dbsb-juntendo/descSPIM/README.md

# descSPIM

**descSPIM : affordable but versatile light-sheet microscopy system for tissue clearing end users**

descSPIM_CAD_for_GitHub_middle

## What is descSPIM?

descSPIM is a lightsheet microscopy system that we designed to meet the unmet needs of researchers who are using tissue clearing techniques. The system offers a low-cost and easy-to-use solution for 3D imaging of cleared tissue samples that requires little expertise and cost. Most optical components are readily available from a single vendor and can be readily assembled using the instructions provided. These minimal optical parts are arranged on a small optical breadboard. In contrast to existing lightsheet systems, descSPIM is intended to be simple to install, build, and operate, even for end users with no prior experience in optics. descSPIM is also highly expandable and can be customized to suit a variety of applications, making it a versatile tool for a wide range of research projects. With descSPIM, researchers can easily achieve practical-quality 3D imaging of cleared specimens in a daily experiments.

descSPIM_cost_vs_expertise_for_GitHub (1)_middle

The main features of descSPIM are:

**✓ Easy-to-build**

**✓ Easy-to-operate (use a cuvette / no oil chamber)**

**✓ Affordable ($20k-50k for descSPIM-basic, depending on the number of lasers)**

**✓ Compact (all parts on a 300 mm x 450 mm breadboard)**

**✓ Versatile (highly expandable and customizable)**

##

## Who is the descSPIM for?

Researchers interested in using **Light-sheet fluorescence microscopy (LSFM)** for cleared tissue imaging

##

## What are ideal imaging applications for a descSPIM?

・Macro- to meso-scale imaging of 3D volumetric samples prepared by tissue clearing techniques with strong efficiency (CUBIC, BABB, DISCO, SHIELDs etc.)

・Visualization of cell populations or anatomical structures (e.g. blood vessels, plaques) with cellular to sub-cellular resolutions

## 

## Guide to install

It is recommended to start learning [Basic of optics](https://github.com/dbsb-juntendo/descSPIM/blob/main/DOCs/Basics%20of%20optics.md) 

and [Cleared sample preparation](https://github.com/dbsb-juntendo/descSPIM/blob/main/DOCs/Cleared%20sample%20preparation.md), 

then to introduce [descSPIM-basic](https://github.com/dbsb-juntendo/descSPIM/blob/main/descSPIM-basic/descSPIM-basic.md). 

Add-on functions are developed to be compatible with the basic system.

Add-ons: (under construction)

Related codes can be found here:  
- For general data processing -> [Data processing](https://github.com/dbsb-juntendo/descSPIM/blob/main/DOCs/Data%20processing.md)  
- For false colored HE (hematoxylin & eosin) 3D converting -> [Fluo-HE](https://github.com/dbsb-juntendo/descSPIM/blob/main/DOCs/Fluo-HE.md)
- For drug distrubution analysis using trastuzumab-DyLightTM 650 -> [DrugDistributionAnalysis](https://github.com/dbsb-juntendo/descSPIM/blob/main/DOCs/DrugDistributionAnalysis.md)

>[!NOTE]
>We only tested the codes python 3.9.16 on Ubuntu 20.04 environment.  
>Registration was performed using ANTs software (v2.4.3.post10-g871cad0).
## 

## FAQ

You can see answers for Frequently Asked Questions [here](https://github.com/dbsb-juntendo/descSPIM/blob/main/DOCs/FAQ.md). 

## 

## Terms and Conditions

<br />This work is licensed under a <a rel="license" href="http://creativecommons.org/licenses/by-nc-sa/4.0/">Creative Commons Attribution-NonCommercial-ShareAlike 4.0 International License</a>.

By using descSPIM, you agree to abide by these terms and conditions:

- This system is only available for academic use. Any use for commercial purposes is strictly prohibited, unless permission is granted by the authors.

- Academic users are allowed to use, apply, and adopt the system in accordance with the CC by 4.0 license policy. This includes modifications, adaptations, and redistribution of the system and its components.

- If any commercial enterprise wants to use, produce, or sell the system, they must contact the authors (suishess-kyu@umin.ac.jp) to request permission.

- All users of the system must acknowledge and refer to the original paper (Otomo et al. bioRxiv 2023) in any publications or presentations resulting from the use of the system.

- The authors are not responsible for any consequences arising from the use of this system as well as related tools, scripts, and software. Users assume all risks and liabilities associated with the use.

- The authors reserve the right to modify or terminate the system and its services at any time, without prior notice.

- Users agree to comply with all applicable laws and regulations regarding the use of the system.

- Any disputes arising from the use of this system shall be resolved through negotiation between the parties. If a resolution cannot be reached, the dispute shall be submitted to binding arbitration in accordance with the laws of Japan.

## 

## References

- [Otomo et al. descSPIM: Affordable and Easy-to-Build Light-Sheet Microscopy for Clearing Technique Users. bioRxiv (2023)](https://www.biorxiv.org/content/10.1101/2023.05.02.539136v2) 

- [Susaki et al. Versatile whole-organ/body staining and imaging based on electrolyte-gel properties of biological tissues. Nat Commun 11, 1982 (2020)](https://doi.org/10.1038/s41467-020-15906-5)

- [Matsumoto et al. Advanced CUBIC tissue clearing for whole-organ cell profiling. Nat Protoc 14, 3506–3537 (2019)](https://doi.org/10.1038/s41596-019-0240-9)

- [CUBIC resource website](http://cubic.riken.jp)
