dbsb-juntendo/descSPIM/Codes and software.md

## Flatfiled correction: ImageJ macro
[Download here](https://github.com/dbsb-juntendo/descSPIM/blob/main/FlatfieldCorrection_IJmacro_ver230406.ijm)

How to use:
1. prepare a reference xy image(1) and a sample xyz stack(2). 

(1) a reference xy image

In order to get the reference image, hogehoge... acquired using dye-solving solution (e.g., CUBIC-R + FITC reagent)...

(2) a sample xyz image stack to be corrected

2. run macro with ImageJ/Fiji
