dbsb-juntendo/descSPIM/descSPIM-basic/descSPIM_3Dimaging_ver230520.pdf

# 3D imaging procedures of descSPIM

# (ver. 230520)

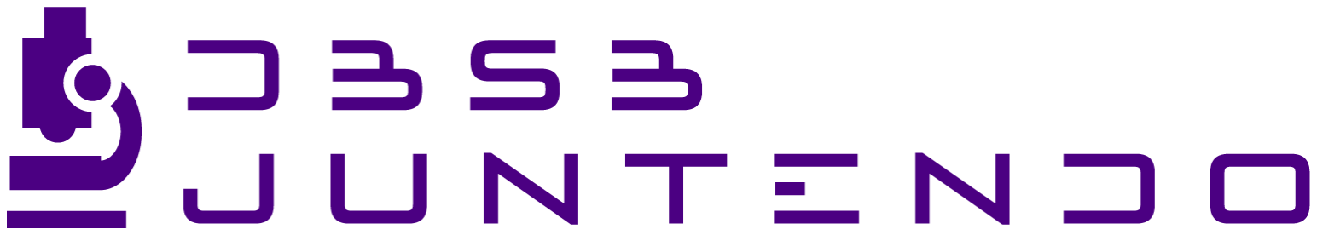
[picture p1: figure]

Provided by Department of Biochemistry and Systems Biomedicine, Graduate School of Medicine, Juntendo University. All Rights Reserved.

## 3D imaging (bioRxiv 2023; Supplementary Fig. 4)

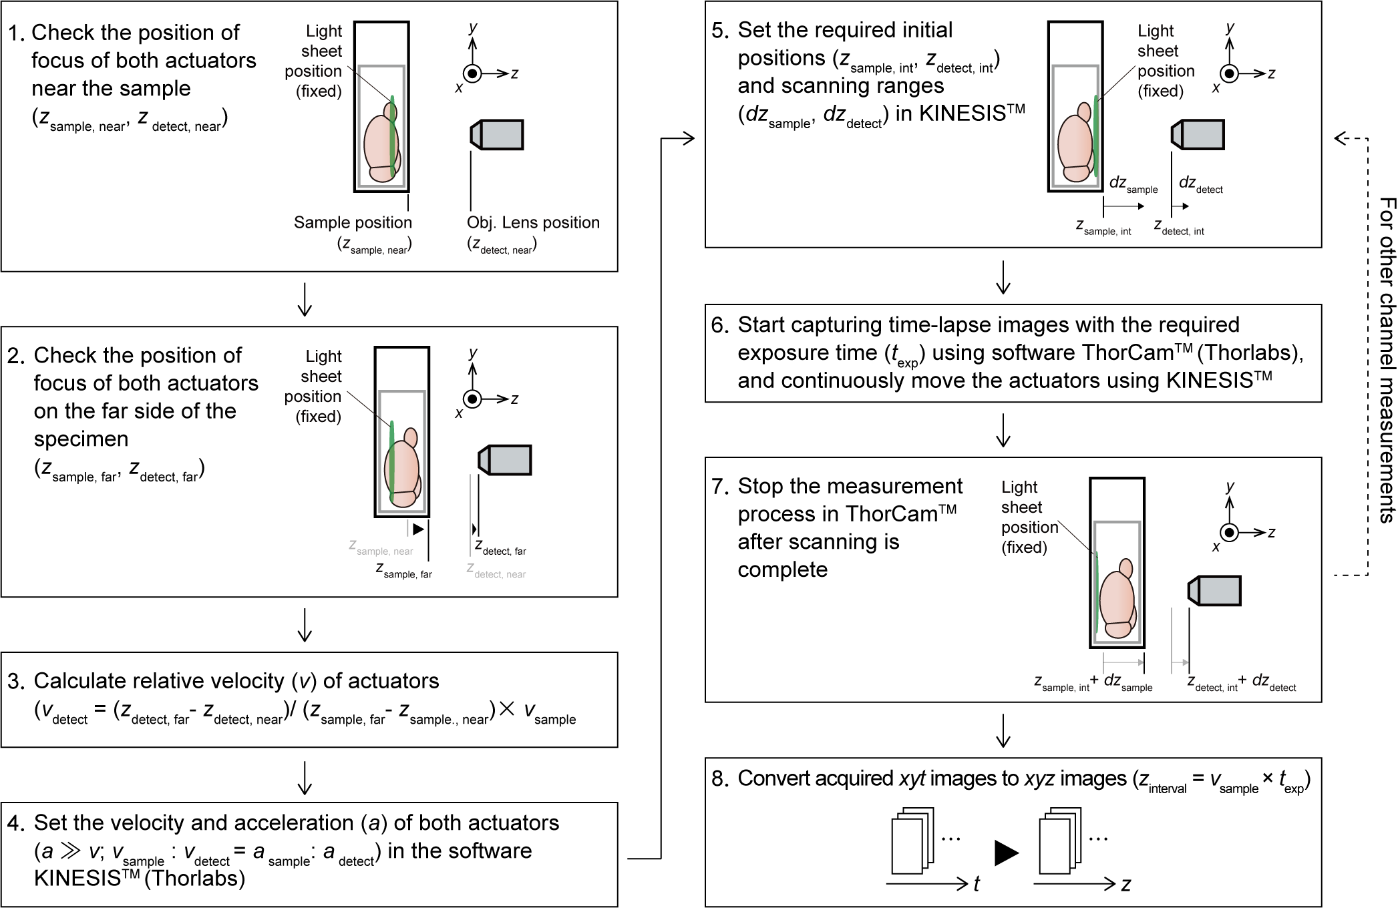
[picture p2: figure]

Detailed procedures about 5-8 are described in following 2 (3) pages

1-4 can be omitted if you use the synchronous speed correction value (the relative velocity of two actuators) estimated from ideal refractive index value as vdetect = ((n-1)/n) × vstage

Acquire continuous time-lapse images utilizing ThorCamTM *1, while moving two motorized stages by "Sequence" function of KinesisTM *2. And convert acquired xyt image dataset to xyz image dataset *3.

*1 Camera and software are exchangable, if they can capture continuous time-lapse images and save them as tif format

*2 Manual jog operation of the speed wheel enables the same job.
*3 Original program to control the whole process is also under construction.

↓Create a new sequence from the sequence tab in KinesisTM

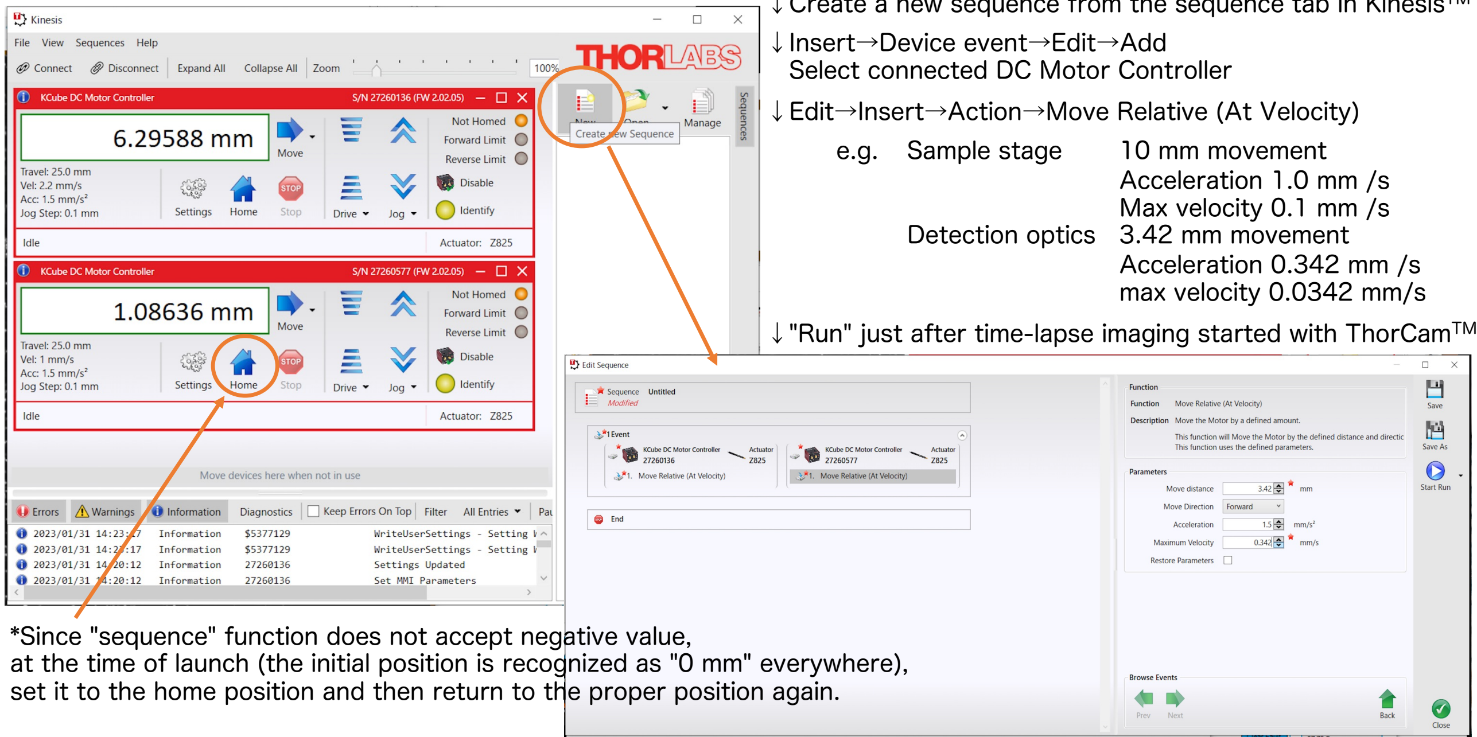
[picture p3: figure]
↓Insert→Device event→Edit→Add Select connected DC Motor Controller; Sample stage; 10 mm movement; Acceleration 1.0 mm /s Max velocity 0.1 mm /s Detection optics 3.42 mm movement Acceleration 0.342 mm /s max velocity 0.0342 mm/s

↓Edit→Insert→Action→Move Relative (At Velocity)

↓"Run" just after time-lapse imaging started with ThorCamTM

*Since "sequence" function does not accept negative value,
at the time of launch (the initial position is recognized as "0 mm" everywhere), set it to the home position and then return to the proper position again.

# 3D imaging

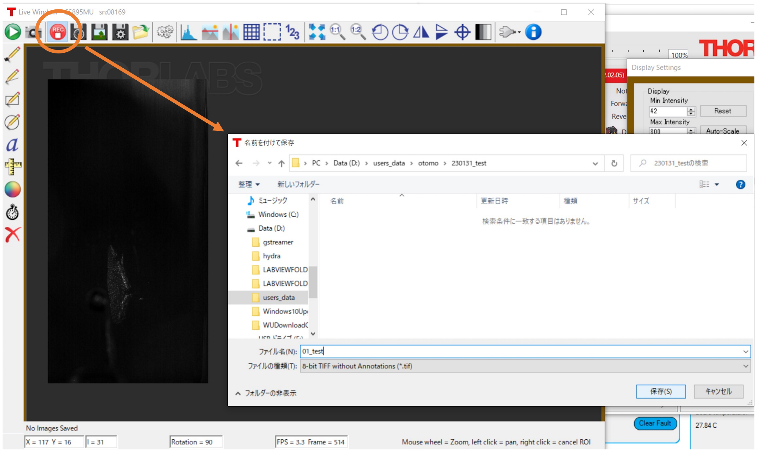
[picture p4: figure]

↓Click the "Rec" button in ThorCamTM.
↓Convert the file format from the default avi to tif, and set the file name and folder in appeared saving panel.
↓Click "Save" to start capturing video.
＊After a slight time lag, "REC" appears on the GUI, then click "Start Run" in Kinesis.
↓Do not forget to click "Rec" to end the imaging

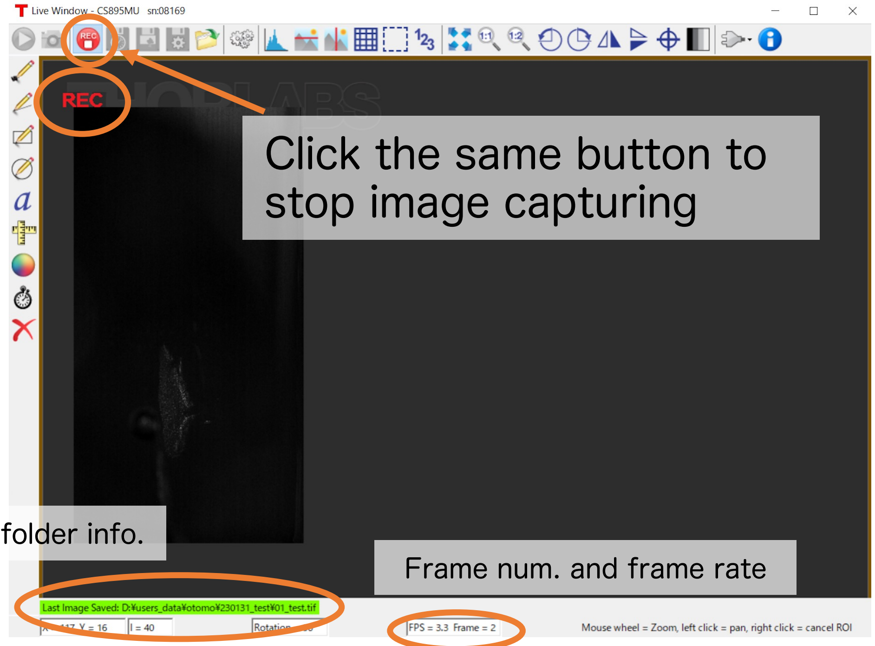
[picture p5: figure]
Frame num. and frame rate; Click the same button to stop image capturing
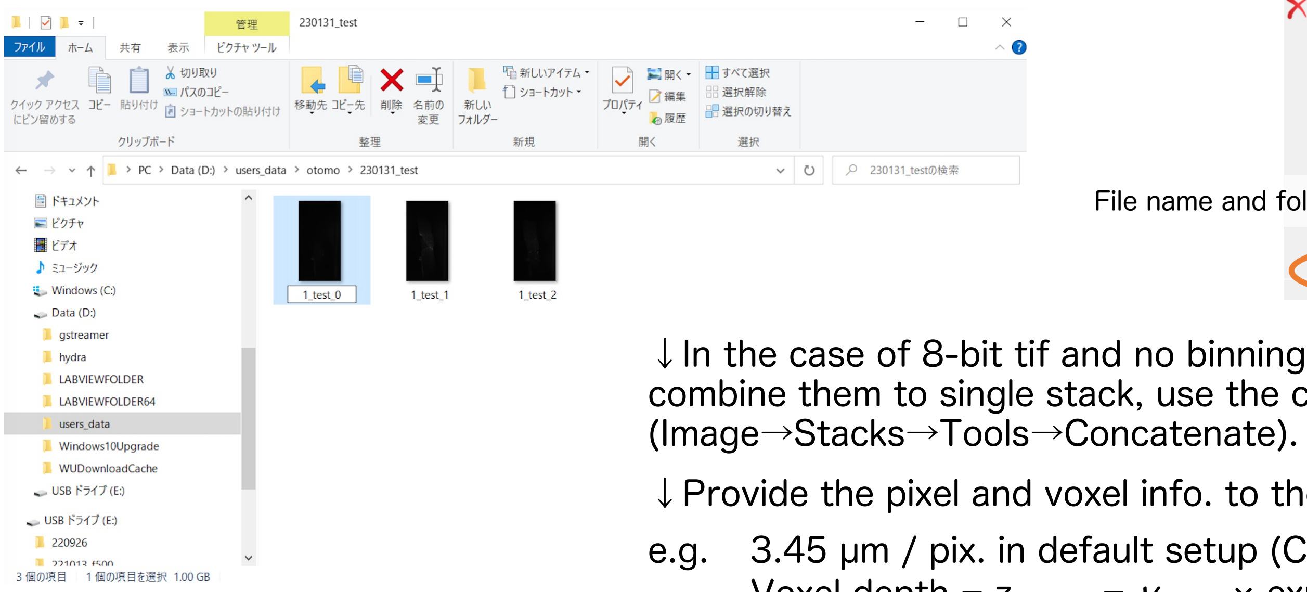
[picture p6: figure]
(Image→Stacks→Tools→Concatenate).

File name and folder info.

↓In the case of 8-bit tif and no binning, a tif file is saved every 122 images (1 Gbyte). To combine them to single stack, use the concatenate function in ImageJ

↓Provide the pixel and voxel info. to the image-stack. (ImageJ: Image→Properties)
e.g. 3.45 µm / pix. in default setup (CS895MU, no binning, TL2XSAP, ftubelens = 100 mm) Voxel depth = zinterval = v stage × exposure time

# 3D imaging

The z-interval (voxel depth) is estimated by the product of vstage and exposure time. However, the set maximum velocity value may be different from actual due to the load capacity of the stage, specifications of the PC, and other unknown factors. Just in case, normalization of the z-interval values using actual measurement data is recommended.

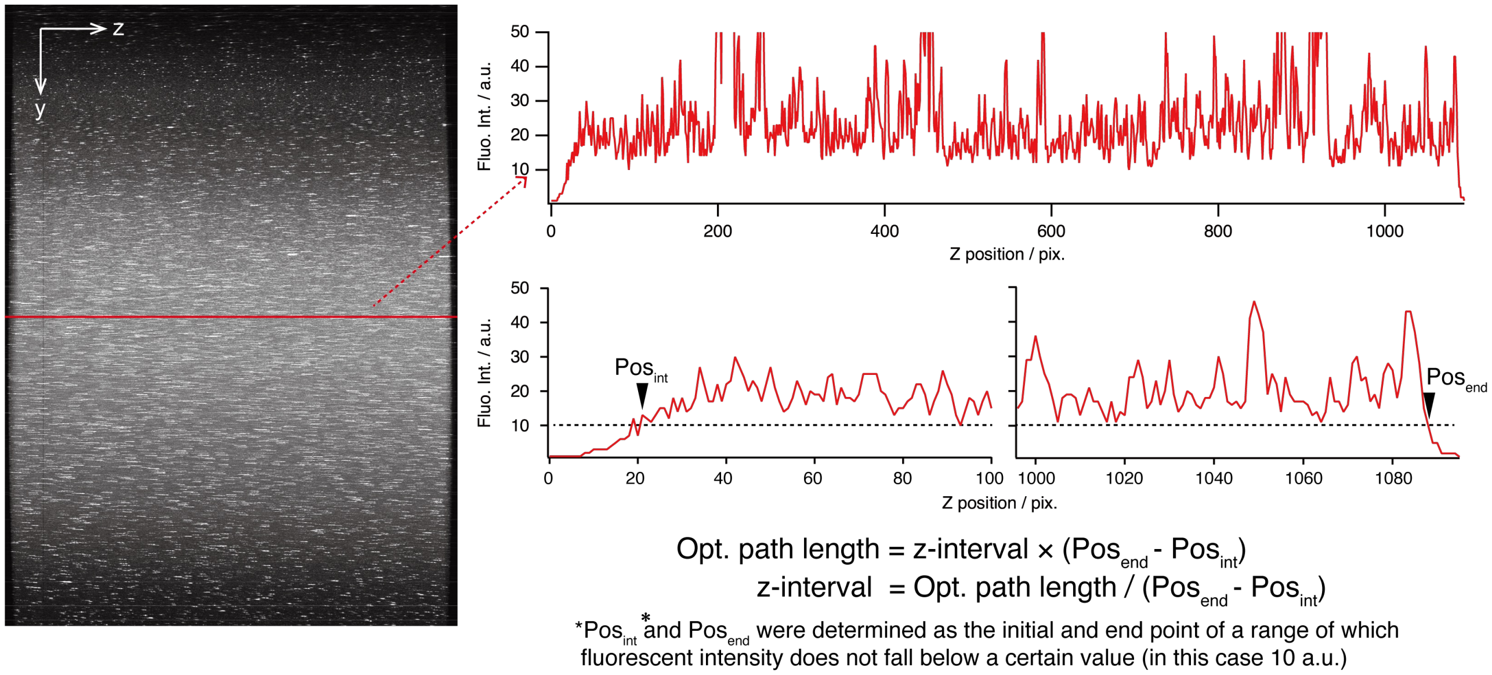
[picture p7: figure]

↓Measure the z-stacked images of gel-embedded fluorescent beads in a cuvette with a 10-mm light path ↓Estimate pix. numbers corresponding to the distance between the inner gel-cuvette interfaces ↓Estimate z-interval as the optical path length divided by the number of pixels

# z-interval normalization (if required)
