dbsb-juntendo/descSPIM/descSPIM-basic/descSPIM-basic.md

# descSPIM-basic

## Introduction

The descSPIM project aims to build an open-source microscopy platform that can be built with low cost and low expertise in optics.

descSPIM_for_GitHub (2)_middle

***

The main features of the descSPIM-basic setup are:

 ● Compatibility with major tissue clearing technologies, including **CUBIC**, **BABB**, **3DISCO/iDISCO**, and **SHIELDS**.
 
 ● The construction can be completed in **half a day**. 
 
 ● It does **not** require a high level of microscopy expertise. 

 ● All parts are commercially available (mostly from Thorlabs).

 ● An affordable cost ($20k-50k) is achieved.
 
 ● A volume imaging completing within **a few minutes**.
 
 ___

## Parts

descSPIM_parts_list_middle

The above image and a breadboard of 30 cm x 45 cm are all the components needed to build descSPIM.
A photo of the completed instrumentation is in **[Introduction](https://github.com/dbsb-juntendo/descSPIM/blob/main/descSPIM-basic.md#introduction)**.
The 3D CAD of the finished drawing is in **[README.md.](https://github.com/dbsb-juntendo/descSPIM/blob/main/README.md)**

### Parts list

The parts list for descSPIM-basic can be downloaded **[here](https://github.com/dbsb-juntendo/descSPIM/blob/main/descSPIM-basic/descSPIM_part_list_230502.xlsx)**.

You can order all the parts (except for laser) to [Thorlabs](https://www.thorlabs.com).

## Construction

### How to construct descSPIM

**descSPIM** is a light-sheet microscope that you can build as if you were assembling a **block toy**. A construction tutorial is provided as follows. You can use the guide throughout the construction procedure.

Below is the manual for the construction procedure.

**[construction manual ver. 230520](https://github.com/dbsb-juntendo/descSPIM/blob/main/descSPIM-basic/descSPIM_construction_ver230520.pdf)**.

**[opt. alignment manual ver. 230520](https://github.com/dbsb-juntendo/descSPIM/blob/main/descSPIM-basic/descSPIM_opticalalignment_ver230520.pdf)**.

## Operation

This section summarizes the operation of descSPIM. Please refer to the following PDF file Explanation MOVIE is also available.

**[3D imaging manual ver. 230520](https://github.com/dbsb-juntendo/descSPIM/blob/main/descSPIM-basic/descSPIM_3Dimaging_ver230520.pdf)**.

(tutrial movie: coming soon)

## Introduced sites

Here is a list of sites related to descSPIM. Please check them.

(coming soon)
