dbsb-juntendo/descSPIM/descSPIM_Python/240119 installation_manusl_of_descSPIM_Python_SE_YN.docx.pdf

240105 Yuki Nozawa

## descSPIM-Python Installation Instructions

※This guide is intended for use with Windows 11.
※Computer specs require at least 64 GB of RAM.

### 1. Environment creation

1-1. Application Installation

1-1-1. Installation of Python
1-1-2. Installation of Anaconda
1-1-3. Installation of Micro-Manager 2.0 1-1-4. Installation of ThorCam
1-1-5. Installation of Kinesis® software 1-1-6. Installation of Arduino IDE

1-2. Environment Setup

1-2-1. Creation of a new environment 1-2-2. Installation of required packages

1-3. initial setup procedure in Micro-Manager

1-3-1. Move TSICam device adapter
1-3-2. Installation of ThorlabsKinesis device adapters 1-3-3. Create configuration files (Satge.cfg, Camera.cfg)
(a) Create configuration file for TSICam
(b) Create configuration file for ThorlabsKinesis 1-3-4. Create configuration file for ThorlabsKinesis

1-4. Initial configuration of Arduino.

1-5. Changing RAM settings in ImageJ

2．Execute Python code

2-1. Running Pre-check.ipynb
2-2. Regarding 240302_descSPIM_Python_versionA.ipynb 2-3. Regarding 240302_descSPIM_Python_versionB.ipynb 2-4. Regarding 240302_descSPIM_Python_completion_file.ipynb

3．Troubleshooting

3-1. Errors related to permissions

3-2. Error due to USB connection failure 3-3. Failure to load Configuration file 3-4. Backslash errors
3-5. Jupyter notebook out of memory 3-6. Errors caused by insufficient RAM

## 1. Environment creation

1-1. Application Installation

Install the required environment from the following URLs.

1-1-1. Installation of Pyhton

https://www.python.org/

Download the installer and follow the instructions to install Python. Select "Add Python to PATH" during installation and add Python to the PATH environment variable. Currently, this
PC is using 3.10.9 | packaged by Anaconda, Inc. | (main, Mar 1 2023, 18:18:15) [MSC
v.1916 64 bit (AMD64)]. Different versions and bit numbers may lead to errors.

1-1-2. Installation of Anaconda

https://www.anaconda.com/download

Run the downloaded installer. Follow the instructions provided by the installer. Usually, the default settings are fine." If you select the option "Add Anaconda to my PATH environment variable", you can use Anaconda from the command line (Windows).
We recommend downloading the latest version of Anaconda Distribution. Currently on this PC, Anaconda uses conda 23.3.1.
Search and open Anaconda prompt from home.

jupyter notebook

Execute the above command and jupyter notebook should be up and running.

1-1-3. Installation of Micro-Manger

https://download.micro-manager.org/nightly/2.0/Windows/

Install the latest version from the above URL. At this time, if the version date is included in the installation, such as "C:\Program Files\Micro-Manager-2.0.231214", change the name to "C:\Program Files\Micro-Manager-2.0".
Next, from the Start menu, select "Control Panel" -> "System" -> "Advanced System Settings" -> "Environment Variables" -> "Path" from "System Environment Variables" -> "Edit" -> "New" -> add the path of the directory where Micro-Manager is installed (e.g. C:\ Program Files\Micro-Manager-2.0)
When editing is complete, click "OK" on all windows to close them. Then restart the PC.

1-1-4. Installation of ThorCam (application for Thorlabs cameras)

https://www.thorlabs.co.jp/software_pages/ViewSoftwarePage.cfm?Code=ThorCam

Install ThorCam Software for 64-Bit Windows from the above URL. Follow the installation guide. Use version 3.7.0.6.

1-1-5. Installation of Kinesis® software (Thorlabs motor application)

https://www.thorlabs.co.jp/newgrouppage9.cfm?objectgroup_id=10285

Install Kinesis® software from the above URL. Follow the installation guide. Use version 1.14.44.

1-1-6. Installation of Arduino IDE

https://www.arduino.cc/

Install Arduino IDE from the above URL. Follow the installation guide. Use version 2.2.1.

1-2. Environment Setting

1-2-1. Creating a new environment

Launch Anaconda prompt and execute the following commands, this will create and activate a new environment (myenv).

python -m venv myenv
myenv\Scripts\activate

Confirm that the environment is activated. You should see the following in your terminal window:

(myenv) (base) C:\Users\username>

1-2-2. Install the required packages

pip install jupyter

pip install pyserial
# Refer to the URL https://github.com/pyserial/pyserial

pip install pythonnet

# Refer to the URL https://github.com/pythonnet/pythonnet

pip install pymmcore-plus
pip install pymmcore_widget#
pip install "pymmcore-plus[cli]" # may not be needed
pip install PyQt5
pip install PyQt6 # may not be needed
# Refer to the URL https://pymmcore-plus.github.io/pymmcore-widgets/

pip install napari-micromanager
mmcore install
# Refer to the URL

https://github.com/pymmcore-plus/napari-micromanager?tab=readme-ov-file

pip install pycromanager
# See URL https://github.com/micro-manager/pycro-manager

pip install keyboard
# reference URL https://github.com/boppreh/keyboard

Execute the above commands while checking the reference URLs.

1-3. Initial setup procedure in Micro-Manager

1-3-1. Moving TSICam device adapters

https://micro-manager.org/TSI

Follow the steps above to move the dll file into the micro manager file." C:\Users\username\Desktop\Scientific_Camera_Interfaces\Scientific Camera Interfaces\SDK\Native Toolkit\dlls\Native_64_lib" and the dll files in the "C:\ Program Files\Micro-Manager-2.0".

Repeat these steps for mmcore installed in your environment “C:\Users\username\AppData\Local\pymmcore-plus\pymmcore-plus\mm\Micro-Manager_2.0 .3_20240306\”

1-3-2. Install ThorlabKinesis device adapter https://github.com/micro-manager/mmdev-ThorlabsKinesis/releases

Download mmdev-ThorlabsKinesis-20230207.71-x64.zip of v20230207.71 from the above URL. Unzip the zip file and copy "C:\Users\username\Downloads\mmdev-ThorlabsKinesis-20230207.71-x64\mmdev-ThorlabsKinesis-20230207.71-x64\mmgr_dal_Th orlabsKinesis.dll" to "C:\Program Files\Micro-Manager Move "C:\Program Files\Micro-Manager-Micro-Manager-2.0".

Repeat these steps for mmcore installed in your environment “C:\Users\username\AppData\Local\pymmcore-plus\pymmcore-plus\mm\Micro-Manager_2.0 .3_20240306\”

1-3-3. Create Configuration File

Launch Micro-Manager from the Start menu.
When Micro-Manager starts up, select "none" in Hardware Configuration File without changing User Profile and click OK to start Micro-Manager.

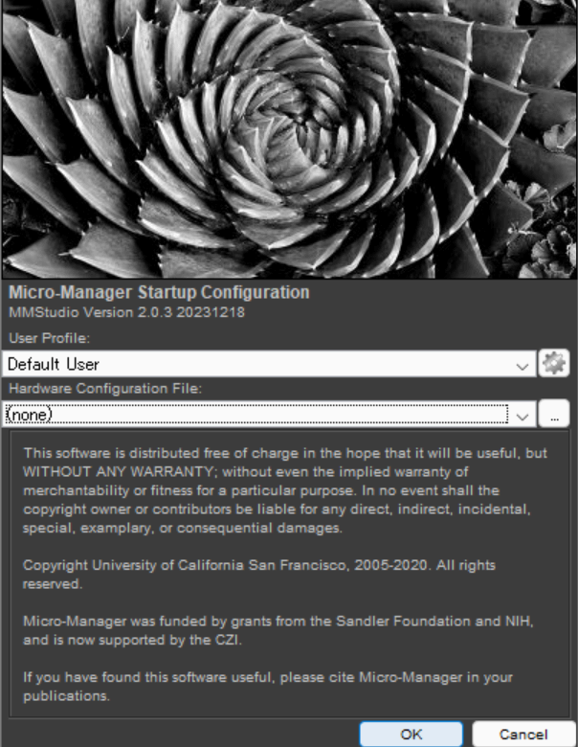
[picture p8: figure]

After Micro-Manager is launched, select device → Hardware Configurartion Wizard from the menu bar.
At this time, make sure that TSICam and KDC101 motors (2 units) are connected to the PC. Poor connection may cause errors.
(a) Creating TSICam configuration file

Select "Create new configuration" and go to Next, select TSI → TSICam: Thorlabs Scientific Imaging camera from Available Devices:, and click "add". The subsequent windows will remain the same and proceed to the following window.

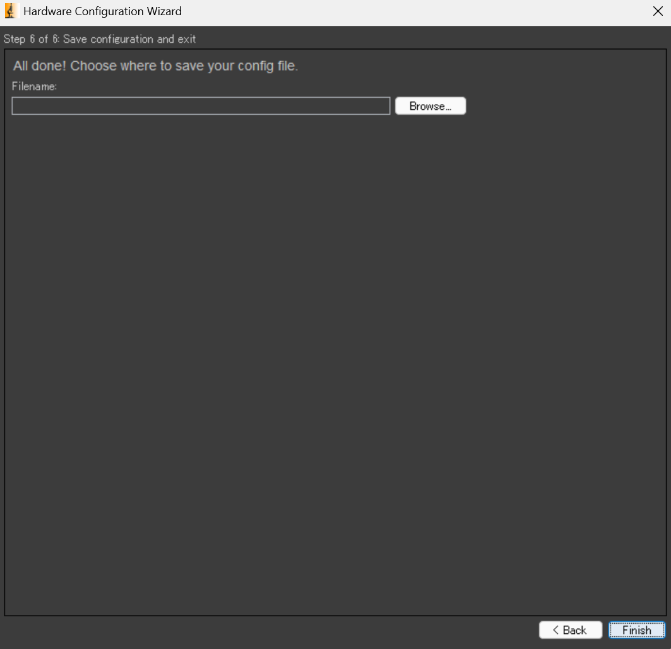
[picture p9: figure]

In this window, specify the file name and file path. For clarity, the file name should include camera. Also, the file path should be on the desktop. (because there are fewer errors related to file calls).
Click Finish to confirm that the configuration file exists in the specified path, then close Micro-Manager.
(b) Creating the ThorlabKinesis configuration file

Launch Micro-Manager again from the Start menu. After launching Micro-Manager, do not change the User Profile, select none in Hardware Configuration File, and click OK to launch Micro-Manager.
Select devices → Hardware Configrartion Wizard from the menu bar, and from Available Devices:, select ThorlabKinesis → ThorlabsKinesis: Thorlabs Kinesis Hub, Click add.
In the next window, the Device Name should remain ThorlabsKinesis.

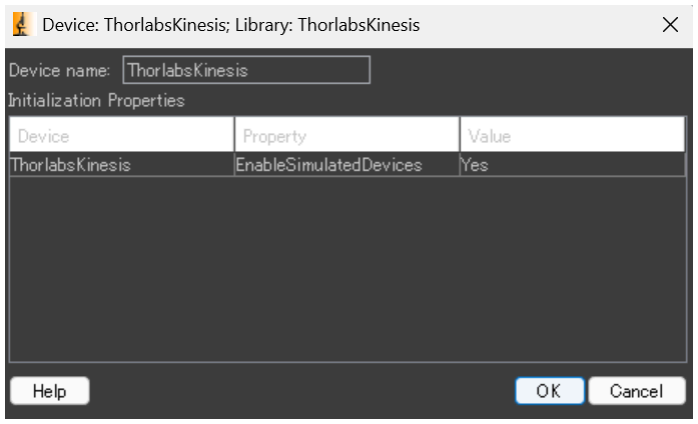
[picture p10: figure]

Select OK and proceed.

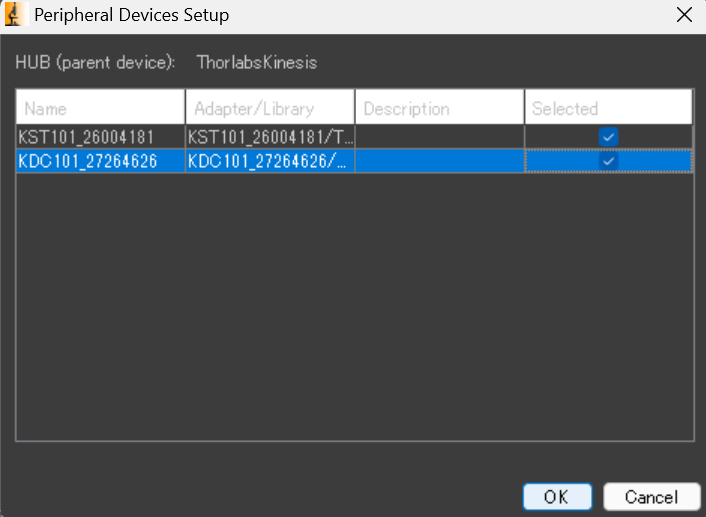
[picture p11: figure]

Confirm that two motors are recognized. After confirming, select all the checkboxes under Selected and click OK.

Check the Device name, which shows the serial number after “KDC_101_”. If it is the number of the stage on the camera side, set the device name to “cameraStage”. Similarly, if it is the sample side, set it to “sampleStage”.

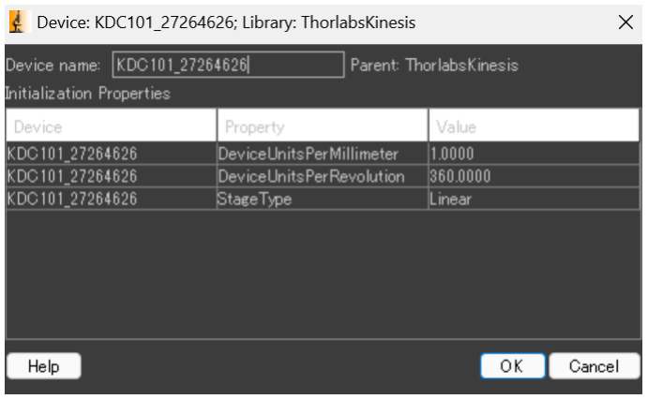
[picture p12: figure]

After changing the Device name, change the value of “DeviceUnitsPerMillimeter” in the first line from 1.0000 to 34555 and the “StageType” to “Linear”.

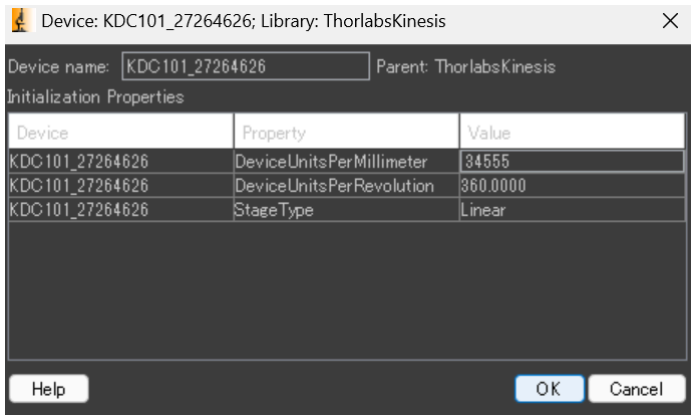
[picture p13: figure]

※The value given to "Value" is specific to the device unit of each motor model, and this value is used in this descSPIM because a Z825B motor is used. See below for the calculation method.
https://github.com/micro-manager/mmdev-ThorlabsKinesis

After, proceed to the same window as before and specify the file name and file path. Click "Finish" to confirm that the configuration file exists in the specified path, and then close Micro-Manager.

1-3-4. Make the Configuration File into a batch file.

Launch Notepad from the Start menu.

@echo off cd "C:\Program Files\Micro-Manager-2.0"
set PATH=%PATH%;C:\Program Files\Micro-Manager-2.0
start ImageJ.exe "C:\Users\username\Desktop\configration file name of camera.cfg"

Copy the above commands into notepad and edit the paths for your installation. It will look like the following:

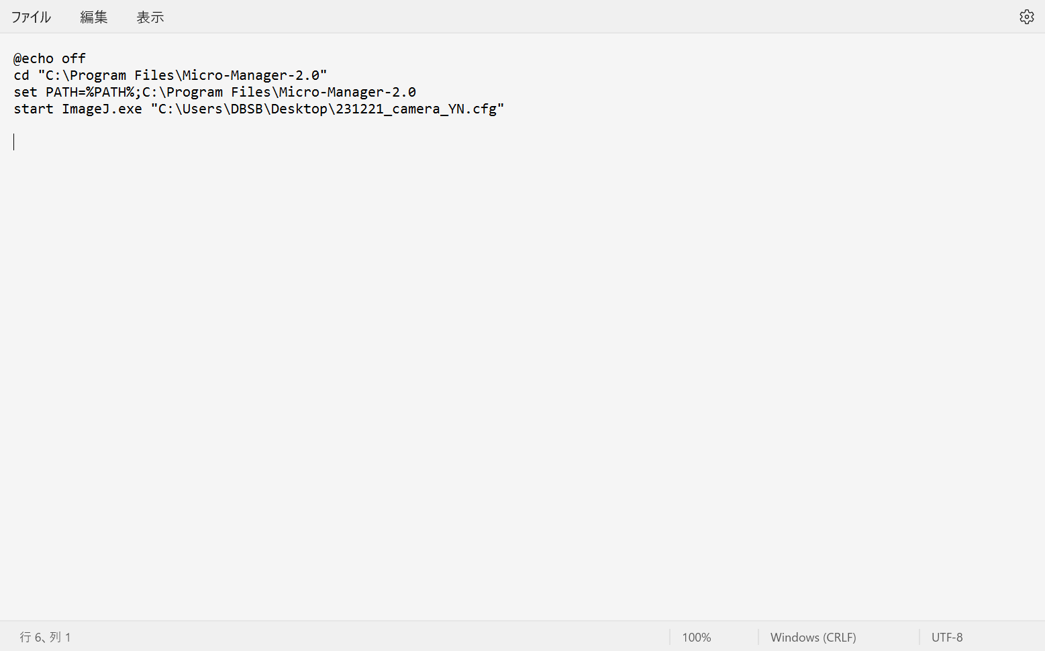
[picture p14: figure]
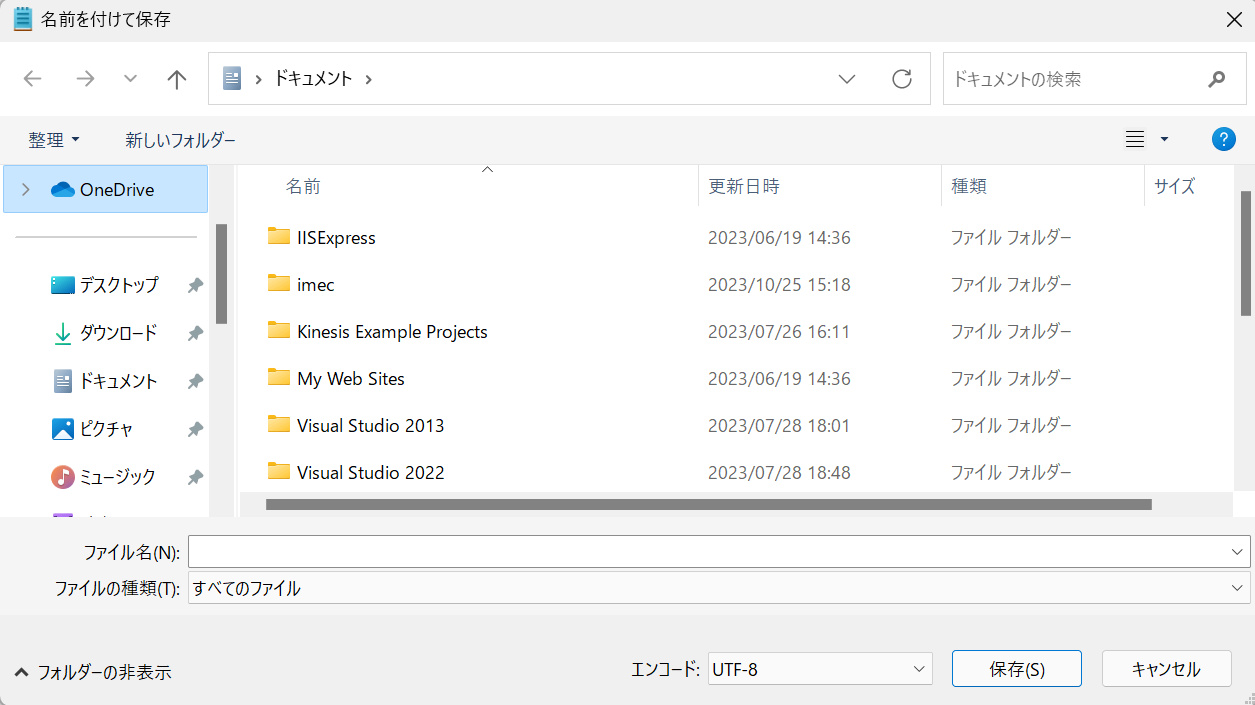
[picture p15: figure]

Select File→Save As and change the file type to All Files.
Fill in the file name as MMcfg.bat. The file name can be arbitrary, as long as you can distinguish it yourself. The preferred destination is desktop.

※ Depending on your environment settings, the batch file may not be necessary.

1-4. initial setup of the Arduino device

Once the Arduino device has been built, connect the device's USB to the PC. Launch Arduino IDE 2.2.1 from Home.

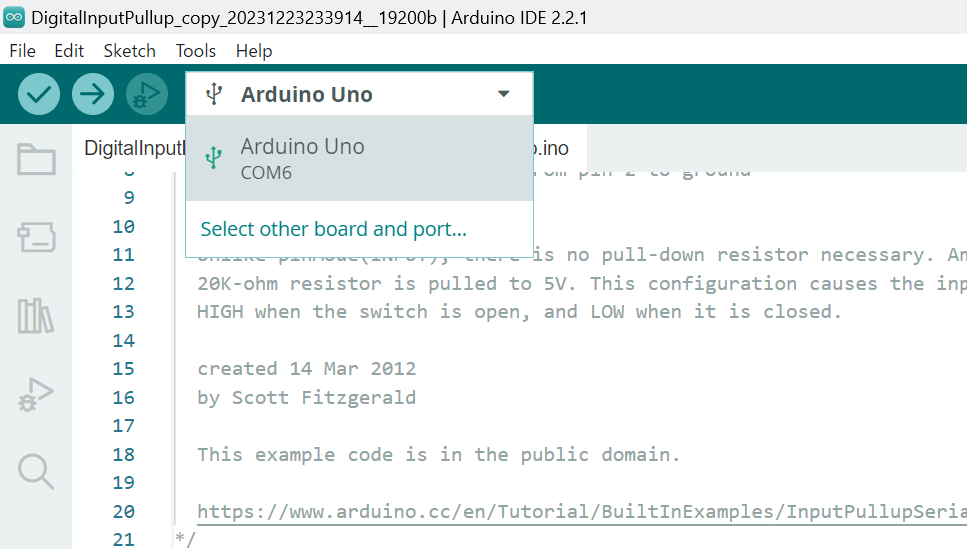
[picture p16: figure]

After launching, click on Arduino Uno in the upper left corner of the window and check the COM number. You will see that it is connected to COM 6 on this PC.
Next, launch Device Manager from Home.

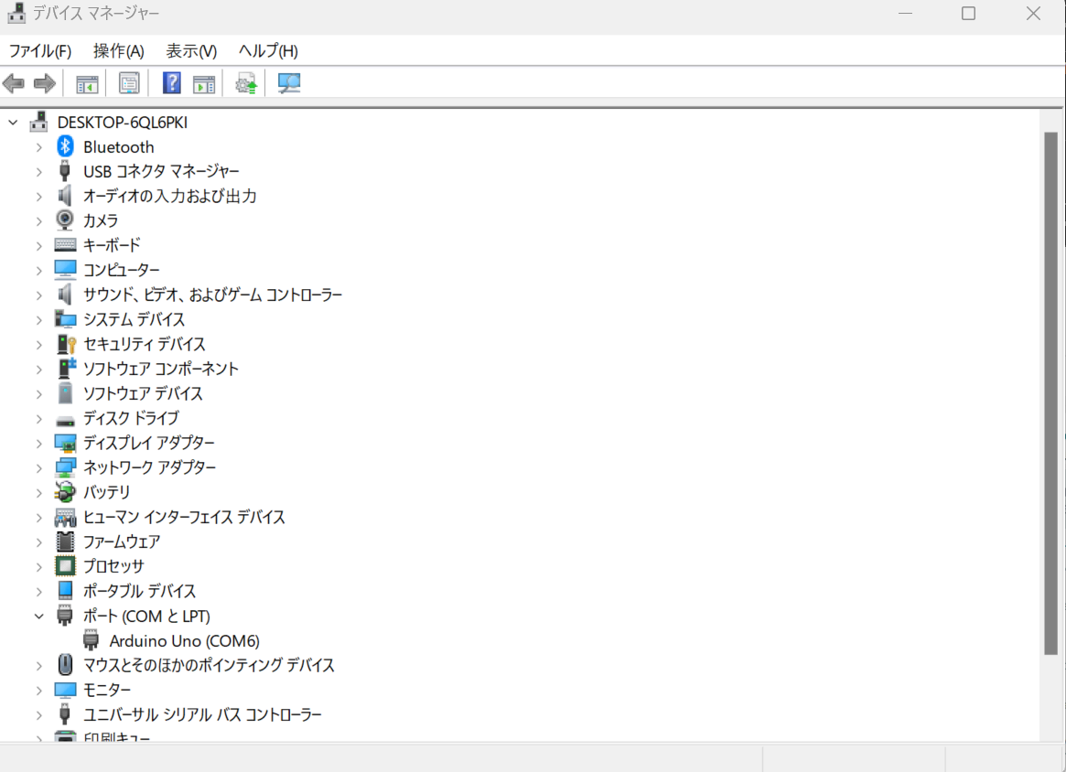
[picture p17: figure]

Ports (COM and LPT) → Verify that the Arduino Uno (COM 6) is connected. This method of checking the connection in the device manager is also useful when checking for program errors that originate from a bad USB connection.
Open "C:\Users\DBSB\Downloads\DigitalInputPullup_copy_20231223233914__19200b.ino" (*231226 file name must be changed) from File→Open.

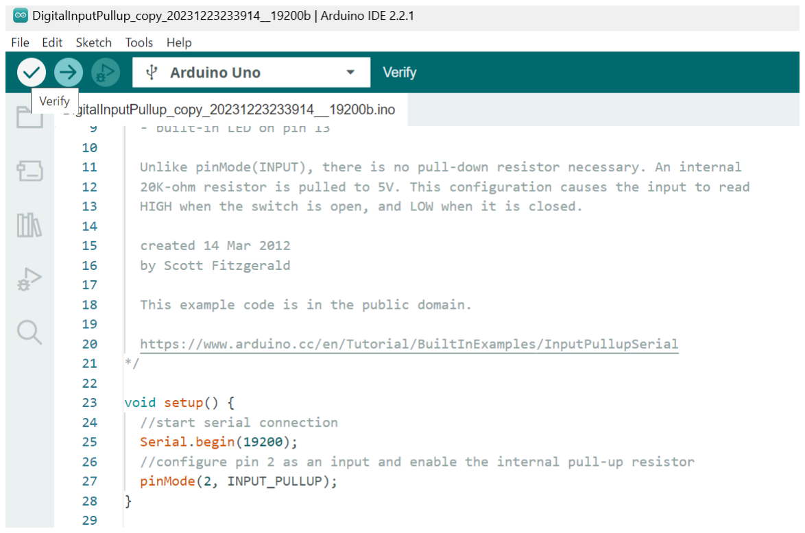
[picture p18: figure]

Click ☑ (Verify) to debug the code. Verify that no errors occur during execution.

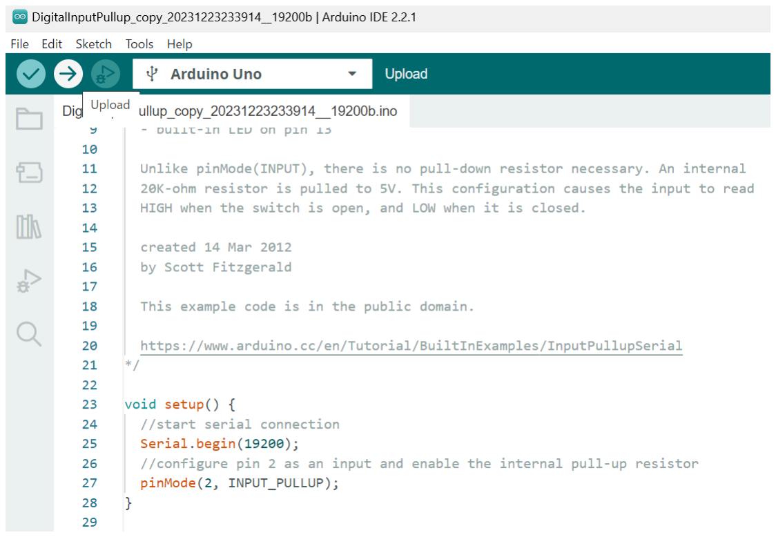
[picture p19: figure]

Click → (Upload) to compile and upload DigitalInputPullup_copy_20231223233914__19200b.ino to the Arduino device. This operation makes the above file uploaded to the device semi-permanently.

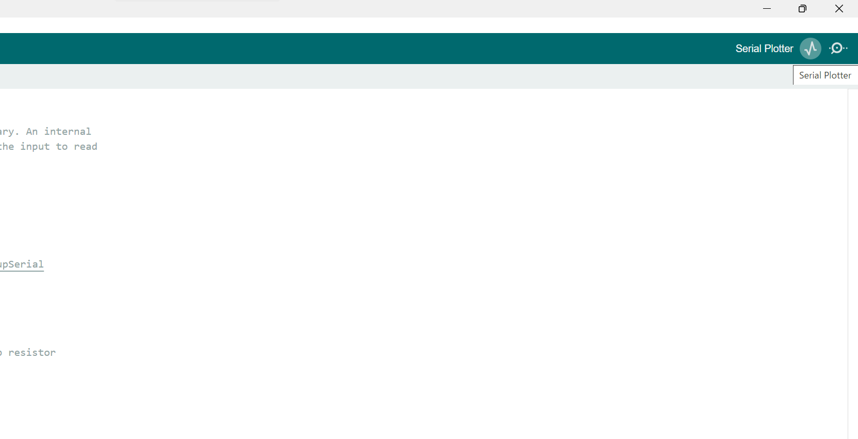
[picture p20: figure]

Next, click on Serial Plotter in the upper right corner of the window to launch the following window.

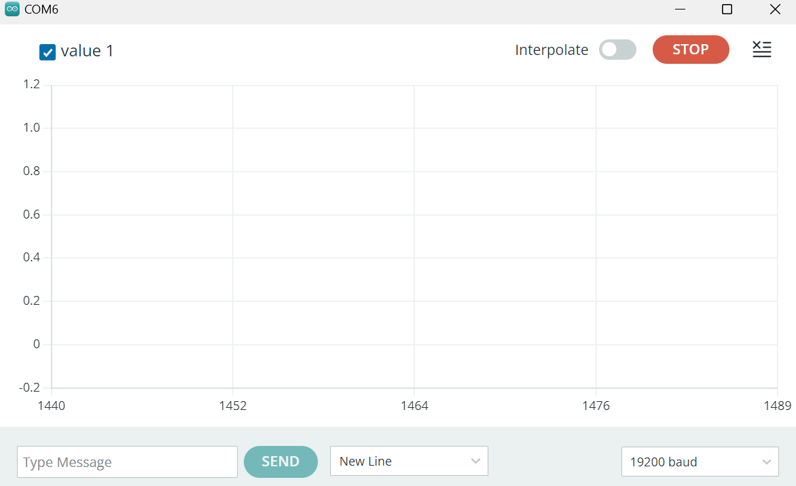
[picture p21: figure]

Change the value of baud in the lower right corner of the window to 19200. Confirm that the horizontal axis of the displayed graph (Time, seconds) is advancing with time. Also, confirm that the signal is displayed on the graph by connecting the two cables of the device.

Once confirmed, verify that the Arduino device is also recognized in jupyter notebook.

myenv\Scripts\activate
jupyter notebook

Launch the above on Anaconda prompt and open a new notebook with File → New → Notebook in the upper right corner of the window.

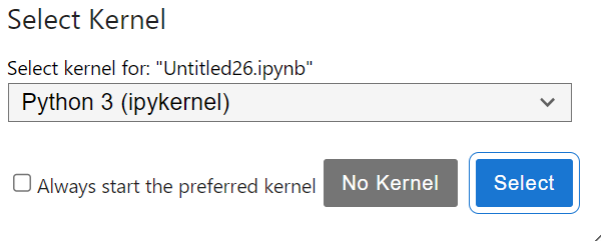
[picture p22: figure]

When the window "Select Kernel" appears, select Python 3 (ipykernel), paste the following code and execute it.

You can also upload the descSPIM_Python program file, select + from the menu bar at the beginning of the program, and open a new cell to perform the same check.

print("Start dumping now!")

######### initialization for USB/Serial ########

import serial
import time
import threading
COM = "COM6" | # Using DEVICE Manager, Check the COM number &
revise if necessary!
bitRate = 19200 | # Serial data transmission speed over USB
(Default 9600 was too slow)

ser = serial.Serial(COM, bitRate, timeout=1)

######### Check the status of Digital Input on Pin 2, Arduino Board ##############

n = 0

def read_serial():
while True:
data = ser.read(512) | # Received 512 bytes (One Packet Data?)
pickup = data[0:1] | # Seems "Bit2" status embedded in this
position...
if pickup.decode("utf-8") == "0":
print(pickup, " | TTL Level = Low, Standby for
REC")
if pickup.decode("utf-8") == "1":

print(pickup, " | TTL Level = High, REC
Started ***")
time.sleep(0.1) | # DO NOT REMOVE THIS DELAY !! Somehow
it's important!

serial_thread = threading.Thread(target=read_serial) serial_thread.daemon = True
serial_thread.start()

input("Press Enter to stop...")

ser.close()

print("END SERIAL")

The above code is designed to continuously acquire the TTL signal of the Arduino device, get the camera's standby and recording, and display and confirm the signal.

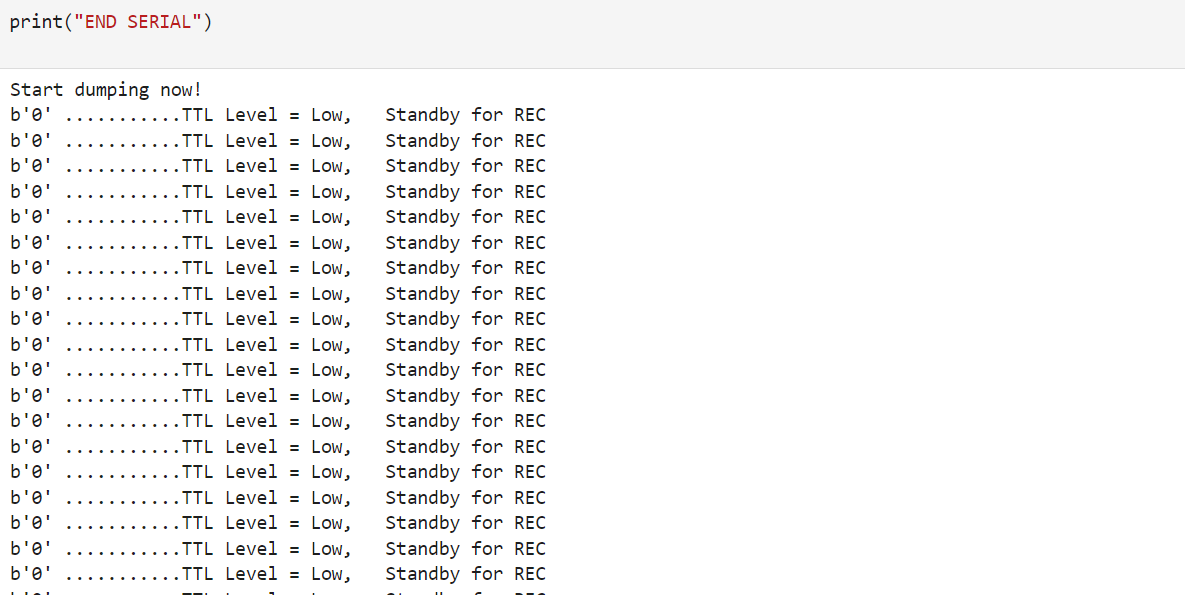
[picture p23: figure]

A series of messages will appear as shown above.
Leave the jupyter notebook tab as it is and start ThorCam. Specify an appropriate file and confirm that the message changes from Standby for REC to REC Started as shown below when you start recording.

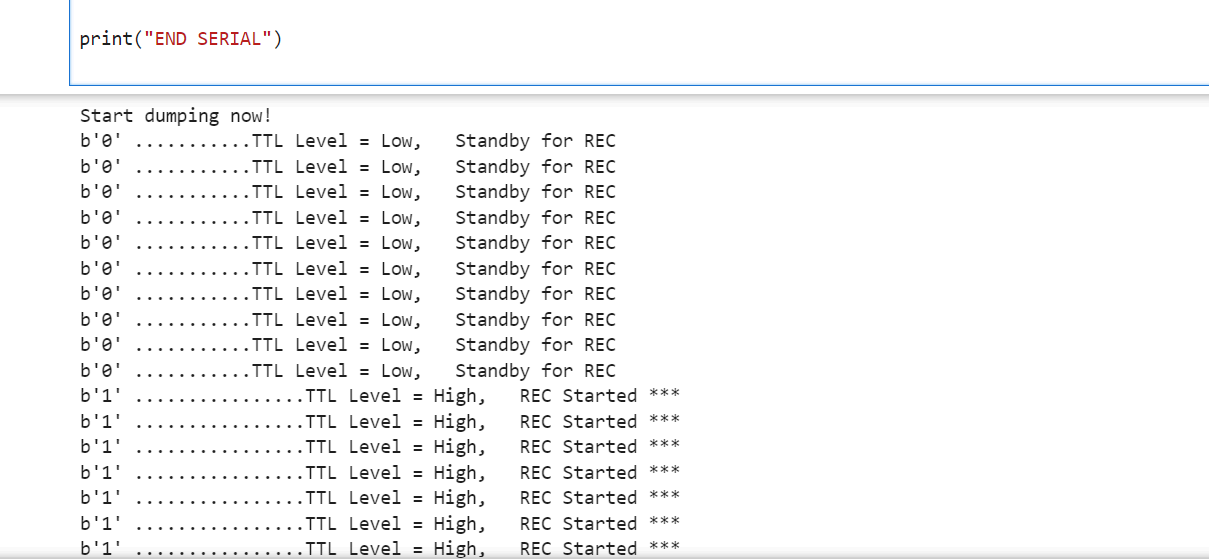
[picture p24: figure]

1-5. Changing RAM settings in ImageJ

Since Micro-Manager uses the RAM as a temporary storage location for captured images, it is essential to change the setting when acquiring large image stacks. The procedure is described below.

Launch Micro-Manager, then launch Edit → Options → Memory & Threads from the imageJ menu bar.

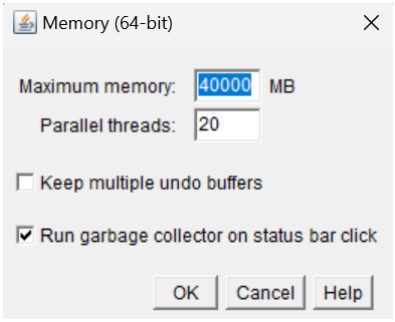
[picture p25: figure]

In the above window, change the value in the Maximum memory box. The number to be added here depends on the number of images acquired in the stack. 1000 images require about 25 GB of storage. Therefore, for this installation, it is recommended that Maximum memory be set to 40000 MB or more.

When acquiring more than 500 images for the first time, it is recommended to open the Task Manager from the Home menu, go to Performance -> Memory, and observe the memory usage while acquiring to make sure that Micro-Manager RAM usage does not exceed its capacity.

See: https://micro-manager.org/Micro-Manager_Configuration_Guide

## 2. Executing Python Code

2-1. Regarding pre-confirmation.ipynb

Launch the myenv environment again from the Anaconda prompt.

jupyter notebook

Execute the above and launch jupyter notebook.
Upload and open the file "pre-confirmation.ipynb". This file is used to verify that the environment you set up in step 1 is functioning properly on jupyter notebook.
Check the cells from the top to the bottom and confirm that there are no differences from the information shown below.

import sys

print("Python Version:")
print(sys.version)

Python Version:
3.10.9 | packaged by Anaconda, Inc. | (main, Mar 1 2023, 18:18:15) [MSC v.1916 64 bit (AMD64)]

import platform

print(platform.architecture())

('64bit', 'WindowsPE')

import subprocess

result = subprocess.run(['conda', '--version'], stdout=subprocess.PIPE)

print(result.stdout.decode('utf-8'))

conda 23.3.1

import os
print("Current Directory:", os.getcwd())

Current Directory: C:\Users\username

import sys
print(sys.path)

['C:\\Users\\username', 'C:\\ProgramData\\anaconda3\\python310.zip', 'C:\\ProgramData\\anaconda3\\DLLs', 'C:\\ProgramData\\anaconda3\\lib', 'C:\\ProgramData\\anaconda3', 'C:\\Users\\username\\myenv', '', 'C:\\Users\\username\\myenv\\lib\\site-packages', 'C:\\Users\\username\\myenv\\lib\\site-packages\\win32', 'C:\\Users\\username\\myenv\\lib\\site-packages\\win32\\lib', 'C:\\Users\\username\\myenv\\lib\\site-packages\\Pythonwin']

import sys
sys.version
'3.10.9 | packaged by Anaconda, Inc. | (main, Mar 1 2023, 18:18:15) [MSC v.1916 64 bit (AMD64)]'

import pkg_resources

pymmcore_plus_version =
pkg_resources.get_distribution("pymmcore_plus").version print("pymmcore_plus version:", pymmcore_plus_version)

pymmcore_plus version: 0.8.4

2-2. Regarding 240302_descSPIM_Python_versionA.ipynb

This file contains the minimum program required for imaging, without detailed functions for imaging.

2-3. Regarding 240302_descSPIM_Python_versionB.ipynb
ここには
This file is useful when you want to perform repetitive imaging of spatially identical structures, such as in the case of multicolor imaging. By keeping the initial and final position values in advance, it is possible to perform the same distance and velocity imaging at the same position any number of times.

2-4. Regarding 240302_descSPIM_Python_completion_file.ipynb
This file is a program that combines all the functions described in 2-3 and 2-4. Initially, we recommend that you use this file and check what functions each cell has.
After that, you will be able to perform imaging efficiently by using the programs 2-3 and 2-4, which are labour-saving programs according to your purpose.

## 3. Troubleshooting

The following is a Q&A on possible errors and how to handle them.

3-1. Errors related to Permission

Permission may differ depending on the initial settings of the Windows PC used. This may be one of the reasons why unexpected errors occur even if the environment is configured correctly.
In this case, start up a file with a user name that has windows permission. In the case of this PC, the file is located in "C:\Users\DBSB Right-click on the file and select "Properties" -> "General" to open the following window.

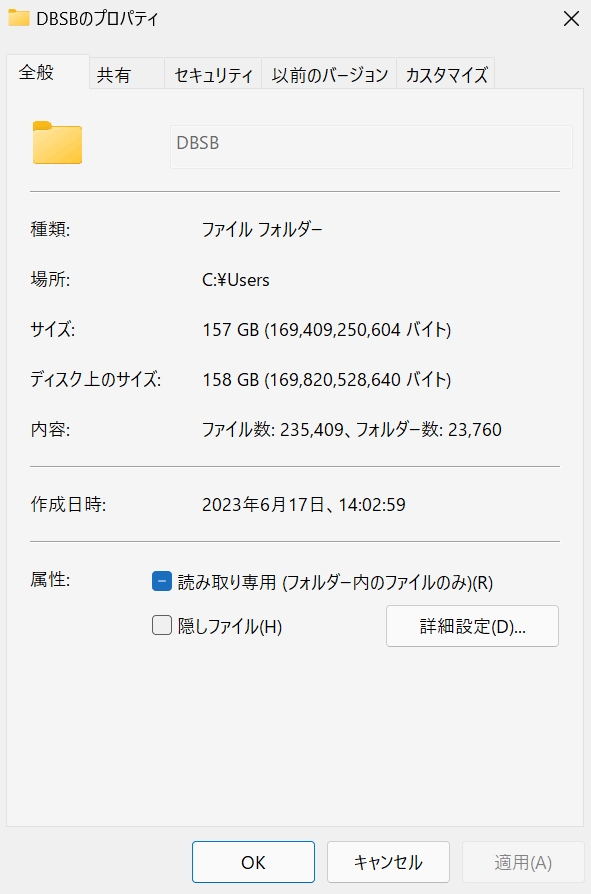
[picture p26: figure]

In the window above, uncheck the Read Only (only files in folders)(R) checkbox and click OK. 3-2.

3-2. Error due to USB connection failure

If you get an error message like "device is not found," the program is not recognizing the device. Make sure that all connected USB adapters are deeply connected. Reconnecting may improve the situation. 3-3.

3-3. failure to load configuration file

If an error message such as "failed to load TSICam" is displayed when Micro-Manager is launched, the configuration file may not be loaded properly. This error indicates that the configuration file created for TSICam (see (3) Initial Setup Procedure in Micro-Manager) failed to load. This may be improved by editing environment variables. Follow the steps below to edit it.

Open "Control Panel" from the Start menu.
→Select "System and Security".
→Select "System".
→Select "Advanced System Settings" from the menu on the left.
→Click the "Environment Variables" button.
→Select "Path" from "System Environment Variables" and click "Edit".
→Click "New" and add the path to the directory where Micro-Manager is installed. Example: C:/Program Files/Micro-Manager-2.0
→When editing is complete, click "OK" to close.
→Click "OK" on all windows to close them in order to save the changes.

3-4. backslash error

When a path is copied and pasted, it is displayed as a backslash like "C:\Program Files\Micro-Manager-2.0". In many cases, this is not a problem, but correcting it to "C:/Program Files/Micro-Manager-2.0" may solve the error. 3-5.

3-5. insufficient memory in Jupyter notebook

Kernel may cause an error due to insufficient memory. Replace the user name with your Windows user name.

cd C:\Users\<ユーザー名>\.jupyter

Open the configuration file jupyter_notebook_config.py in a text editor. Start Notepad and open the configuration file using the following command.

notepad jupyter_notebook_config.py

This allows Notepad to open the configuration file.
Once the configuration file is generated, edit the configuration file using a text editor. Execute the following command.

notepad C:\Users\<ユーザー名>\.jupyter\jupyter_notebook_config.py

The location of the configuration file should be adjusted according to the actual installation location.
Edit the configuration file and set the memory usage limit.

For example, add c.NotebookApp.max_mem_rate and set the value as follows.

c.NotebookApp.max_mem_rate = 0.9

This setting allows the notebook to use up to 90% of the available memory. Restart Jupyter Notebook by executing the following command.

jupyter notebook

Free memory by stopping other processes.

To free up memory by stopping other processes, it is necessary to use a tool such as Task Manager or System Monitor to check the running processes and terminate any unnecessary processes.
Click on the icon at the far right of the taskbar (usually the "^" up arrow) and select "Task Manager" from the task tray. (Or press Ctrl + Shift + Esc at the same time.) The Task Manager window will appear, and select the "Processes" tab. In the Process tab, look for processes that are using a lot of memory (or CPU). Those processes are likely to be consuming system memory.
Select the unneeded process and click the "End Process" button at the bottom of the screen to terminate the process. However, do not change them so that they do not affect the system or important applications.
Insufficient memory resources may also be a problem.
Insufficient memory can lead to a kernel crash. Memory usage should be checked in detail and additional memory should be added if necessary.
Check the Jupyter Notebook log for error messages and details of the problem. Logs are usually stored in the ~/.jupyter directory. Checking the error messages will help identify the problem.
Notebook cells are expected to be executed in order from first to last, executing cells in the wrong order may lead to errors.

How to check the Jupyter Notebook log

By checking the logs, it is easier to identify error factors.
Identify the location of the log file
Jupyter Notebook log files are usually stored in the ~/.jupyter directory. However, the default log file name is jupyter.log. Since the location and name of the log file can be changed, the following command is used to identify a reliable location.

jupyter --paths

This command will show the location of Jupyter Notebook configuration files, log files, etc. Identify the location of the log files.

Viewing the log files

Open Anaconda prompt and navigate to the directory where the log files reside.

cd ~/.jupyter

View log files using a text editor View log files using a text editor.

notepad jupyter.log

Checking Error Messages in Log Files

Log files contain execution logs and error messages from Jupyter Notebook. By examining error messages and problem details, you may be able to identify the root cause of the issue.

3-6. Error Due to Insufficient RAM

If you are using a PC with less than 64 GB of capacity, or if you already have other applications running on a PC with more than 64 GB, you may encounter issues related to insufficient RAM. When using a computer with insufficient RAM, the kernel may crash, preventing the execution of cells. Follow the steps below to check and optimize your RAM:

It is recommended to use a system with more than 64 GB of capacity, especially when dealing with large stacks.

Checking RAM:

Open Task Manager.
Once Task Manager is open, click on the "Performance" tab at the top.
Click on the "Memory" section to display RAM information. Here, you can check the total installed RAM capacity and the amount of RAM currently in use.

Optimizing RAM:

Optimizing RAM is achieved by terminating unnecessary processes and applications. Below are some possible optimization methods:

Terminating unnecessary applications:

Open Task Manager and select unnecessary applications from the task list. Click the "End Task" button to terminate them.

Managing applications that automatically start at boot:

Click on the "Startup" tab in Task Manager.
Disable applications that start automatically at boot to reduce unnecessary processes during system startup.

Use the Disk Cleanup tool to delete unnecessary files and temporary files, freeing up disk space.
