dbsb-juntendo/descSPIM/(commit log)

2023-03-13 Create Sample preparation.md
2023-03-13 Update Sample preparation.md
2023-04-07 Update and rename Sample preparation.md to Cleared sample preparation.md
2023-05-02 Update Cleared sample preparation.md
2023-05-09 Moved files
    [descSPIM_part_list_230502.xlsx]
2023-05-19 Cleared sample preparation.md
2023-11-17 Added sample_images
2023-11-17 Added sample_images directory
2023-11-17 Removed sample_images directory
